prstshojaei/smart-indoor-air-quality-mould-monitor/evidence/Evidence_of_system.docx

Evidence of system

# Part A. Hardware design

## System


System architecture

## Schematic


Power input and charging


Battery and voltage regulation


5 V boost converter


Microcontroller


Programming header


CO2 sensor


Air quality sensor


PM2.5 sensor connector


OLED display


Status LED

## PCB layout and design check


PCB layout, 2D


PCB layout, 2D


PCB, 3D top side


PCB, 3D bottom side


Design Rule Check report

# Part B. Evidence

## Prototype and components


Breadboard prototype


ESP32 board


SCD40 CO2 sensor


BME688 sensor


PMS5003 PM2.5 sensor


PMS5003 panel


PMS5003 UART adapter

## OLED display and serial output


OLED readings page


OLED network page


OLED mould-score page


Serial console, start-up


Serial console, WiFi and web server

## Web dashboard and data log


Dashboard, main page


Dashboard, lower part


Dashboard on a phone, main page


Dashboard on a phone, trend page


Trend page, 24 hours


Trend page, 7 days


CSV log in Excel

## Algorithm validation


Synthetic dataset

Python reference run


ESP32 test run


Mould index over the year

## Real-world test


Dashboard, 19 September 23:58


Dashboard 7-day temperature


Dashboard 7-day humidity

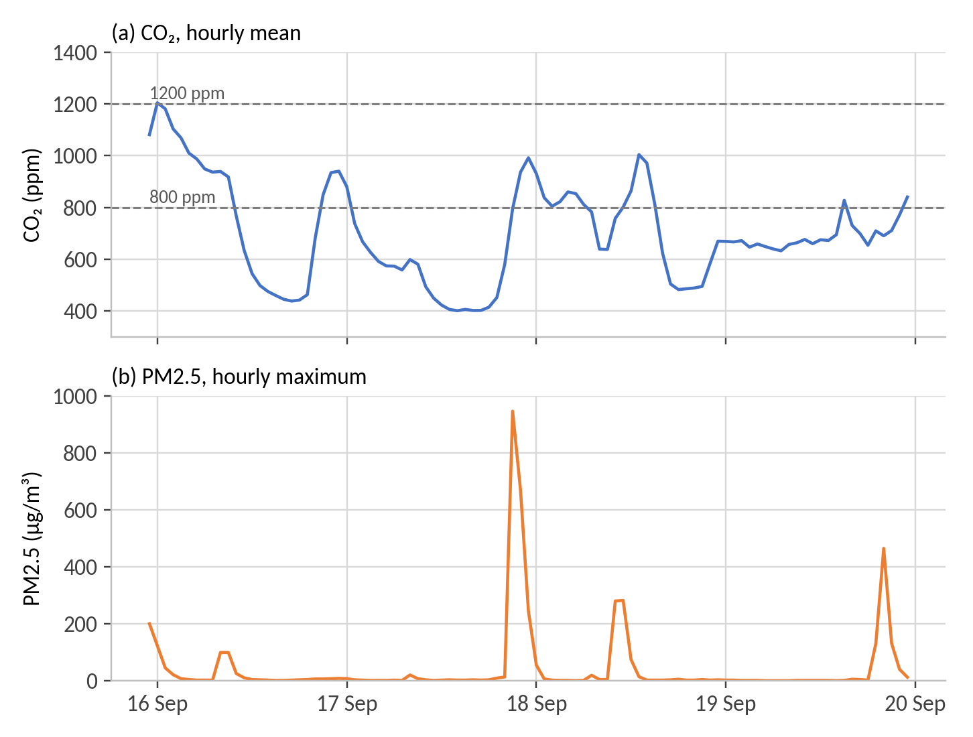
[picture p49: figure]

CO2 and PM2.5, real log

## Comparison with the Airthings Wave Mini


Prototype and Wave Mini


Wave Mini 7-day temperature


Wave Mini 7-day humidity


Wave Mini app, 19 September 23:57


Wave Mini colour light
