prstshojaei/smart-indoor-air-quality-mould-monitor/Evidence/Evidence of system.pdf

# Evidence of system

# Part A. Hardware design

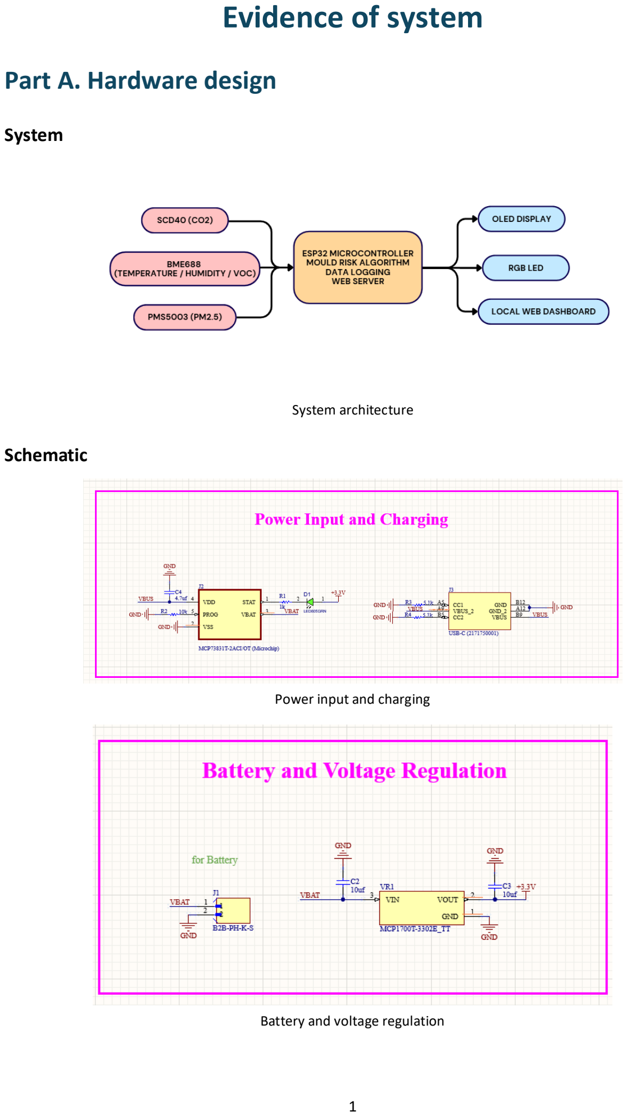
[picture p50: page 1]

## System

System architecture

## Schematic

Power input and charging

Battery and voltage regulation

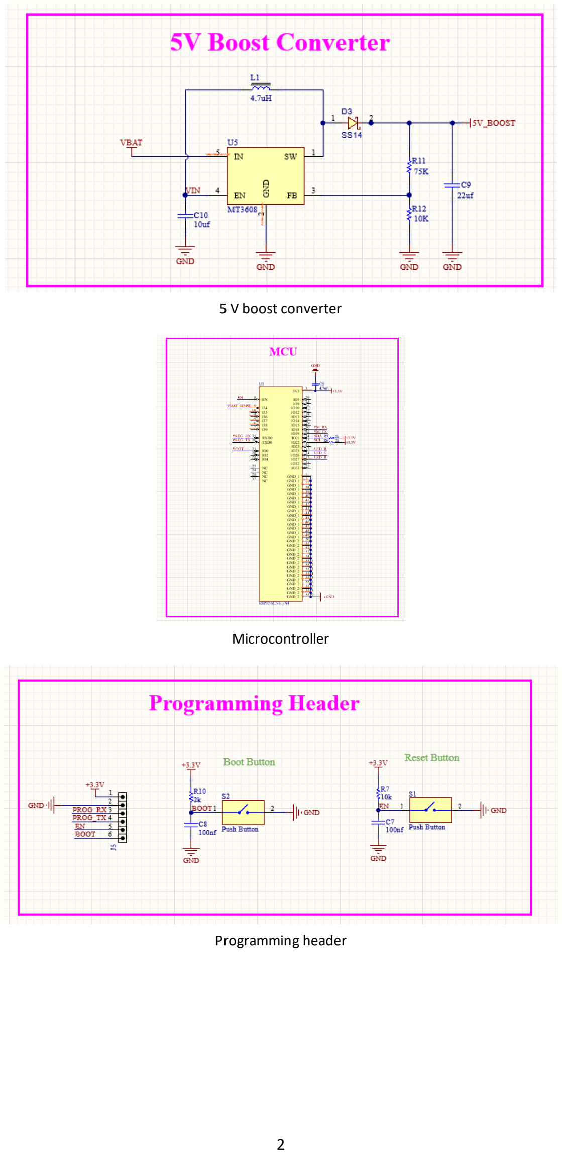
[picture p51: page 2]

5 V boost converter

Microcontroller

Programming header

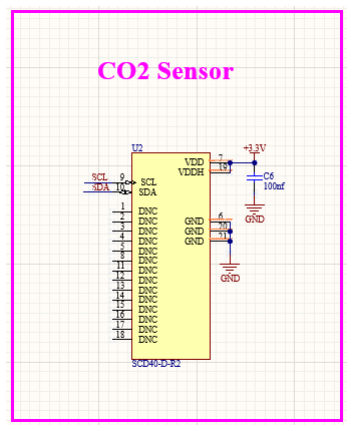
[picture p52: figure]

CO2 sensor

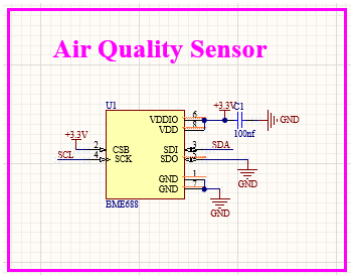
[picture p53: figure]

Air quality sensor

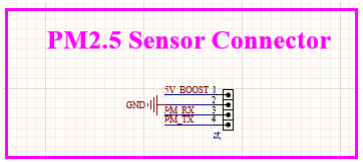
[picture p54: figure]

PM2.5 sensor connector

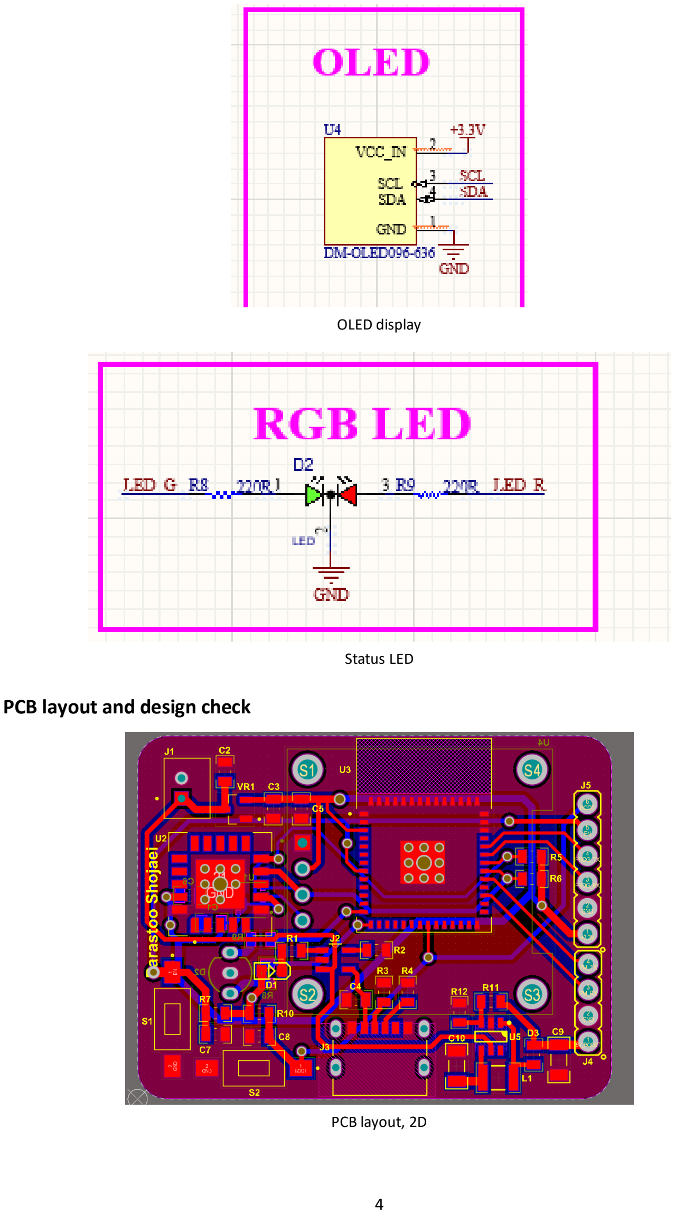
[picture p55: page 4]

OLED display

Status LED

## PCB layout and design check

PCB layout, 2D

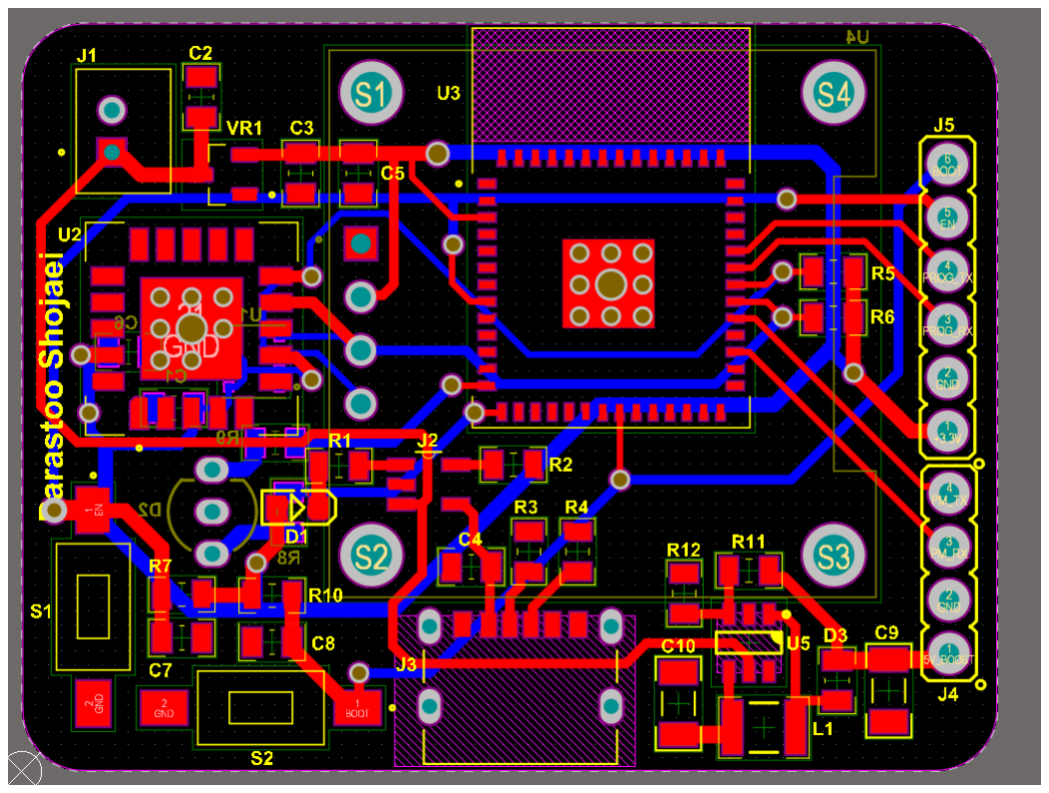
[picture p56: figure]

PCB layout, 2D

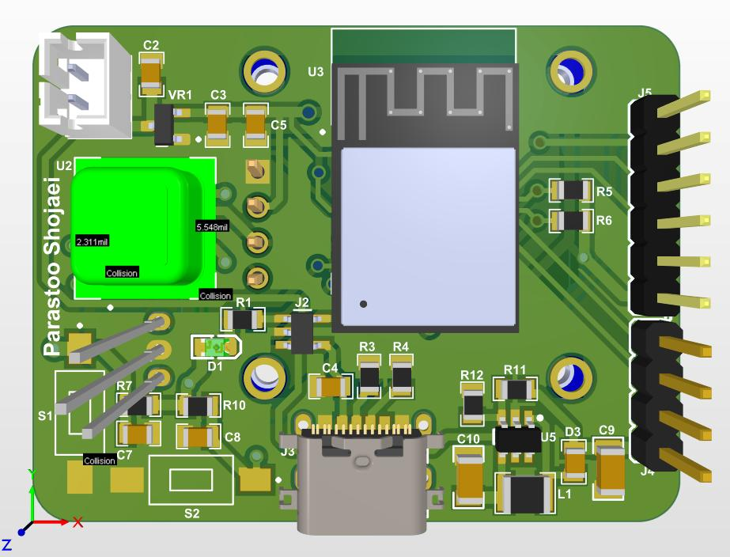
[picture p57: figure]

PCB, 3D top side

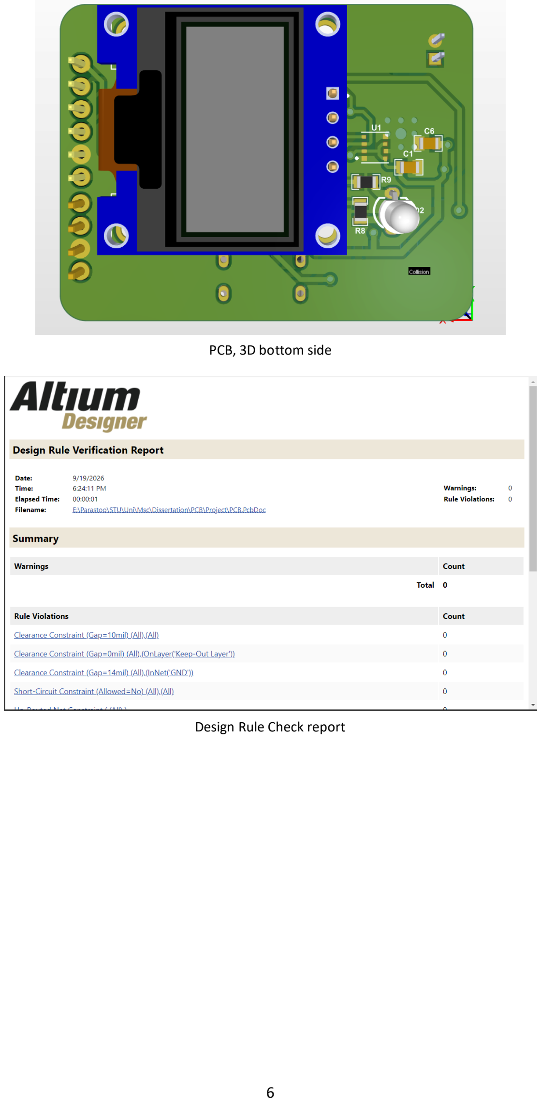
[picture p58: page 6]

PCB, 3D bottom side

Design Rule Check report

# Part B. Evidence

## Prototype and components

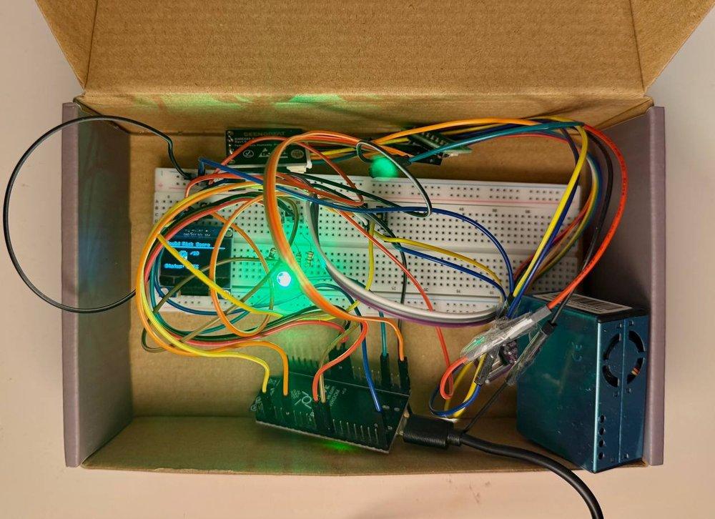
[picture p59: figure]

Breadboard prototype

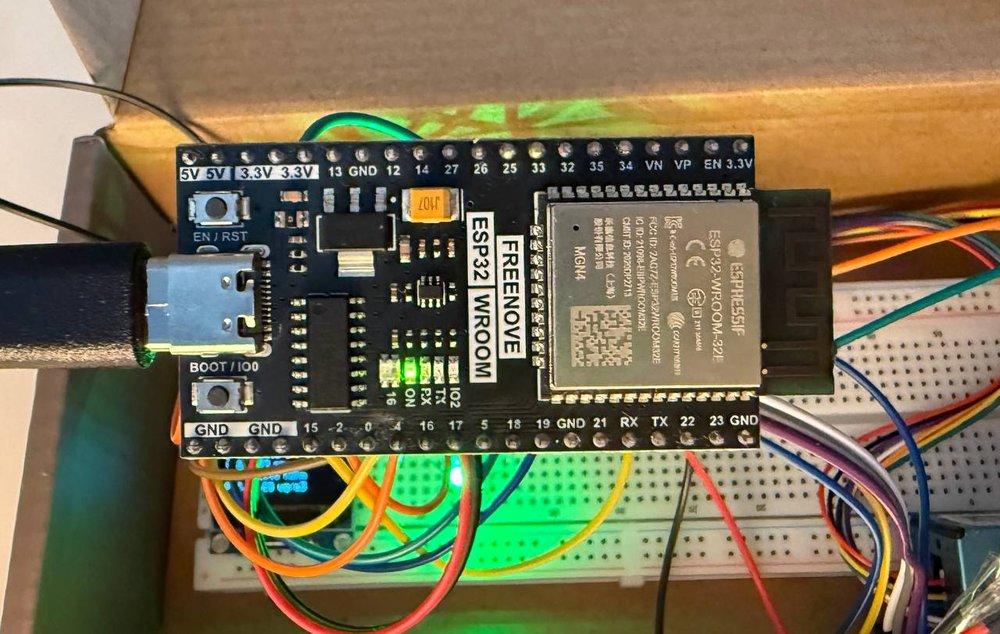
[picture p60: figure]

ESP32 board

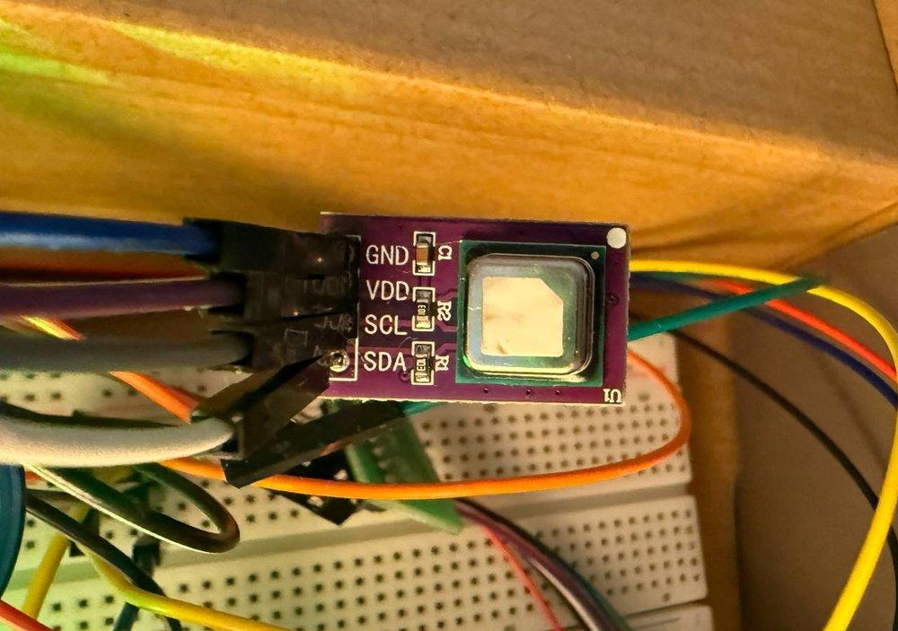
[picture p61: figure]

SCD40 CO2 sensor

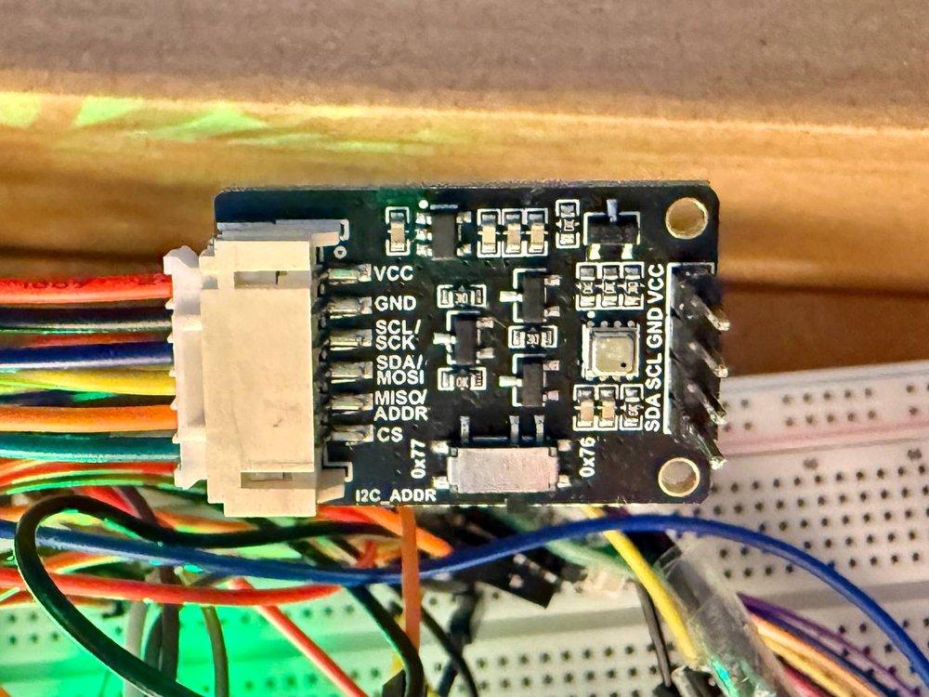
[picture p62: figure]

BME688 sensor

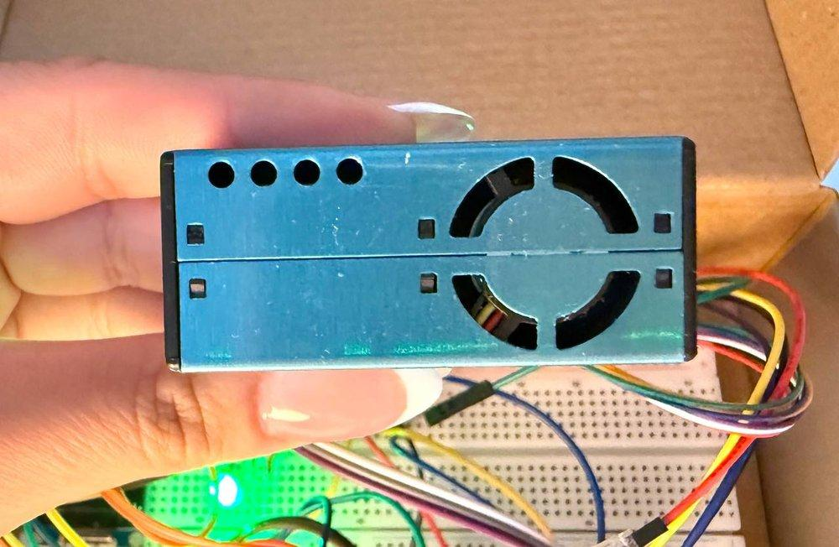
[picture p63: figure]

PMS5003 PM2.5 sensor

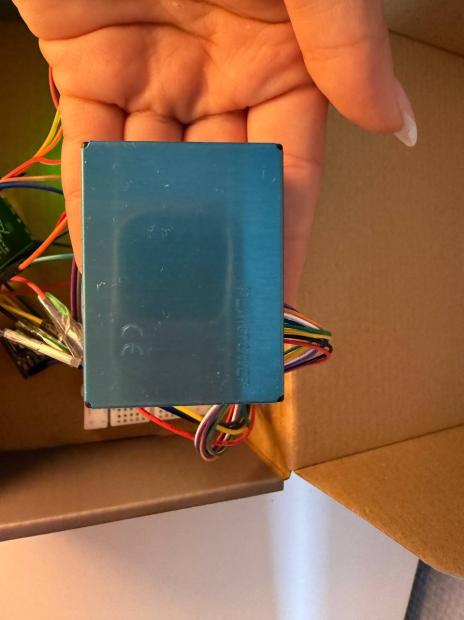
[picture p64: figure]

PMS5003 panel

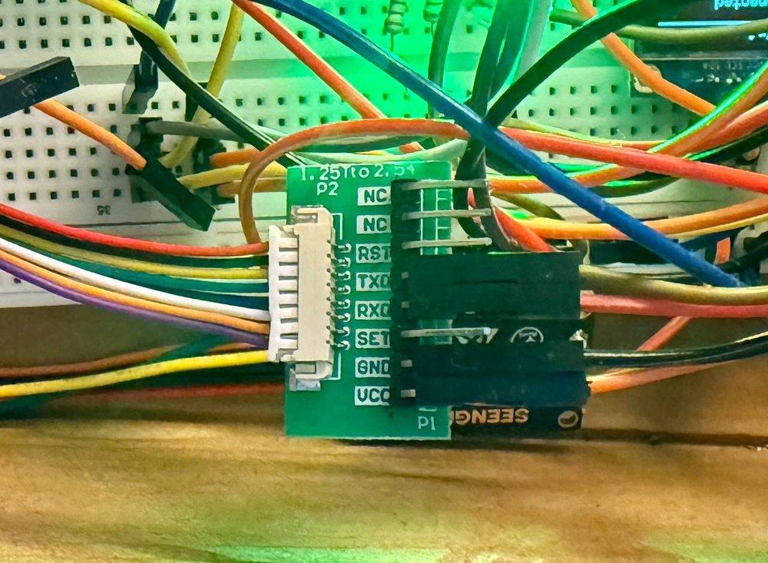
[picture p65: figure]

PMS5003 UART adapter

## OLED display and serial output

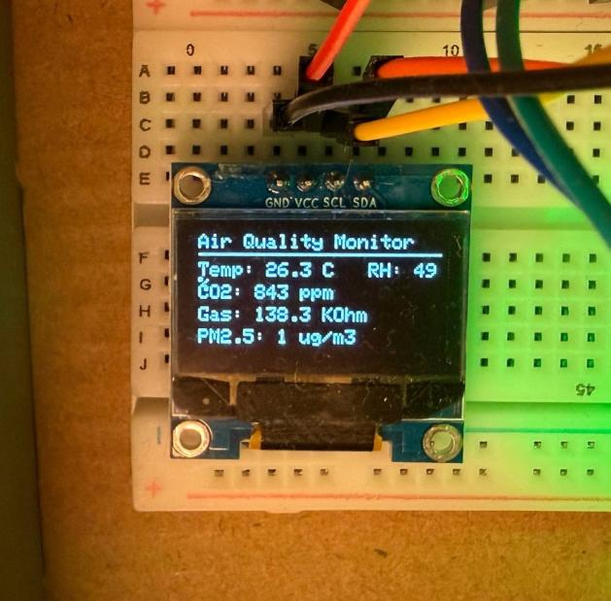
[picture p66: figure]

OLED readings page

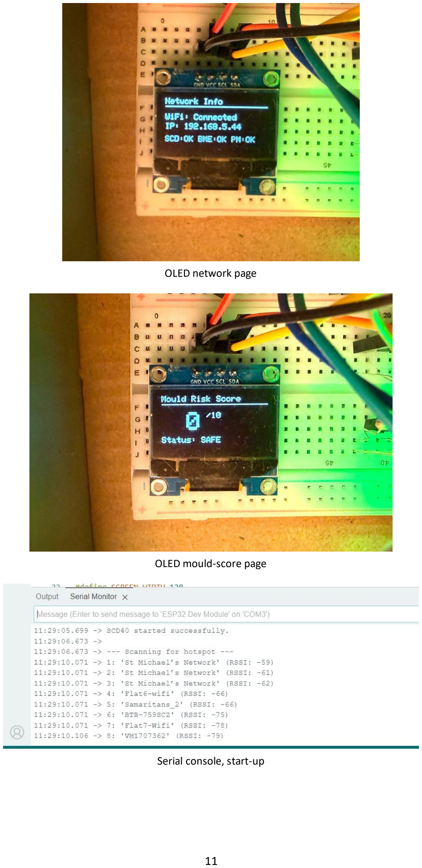
[picture p67: page 11]

OLED network page

OLED mould-score page

Serial console, start-up

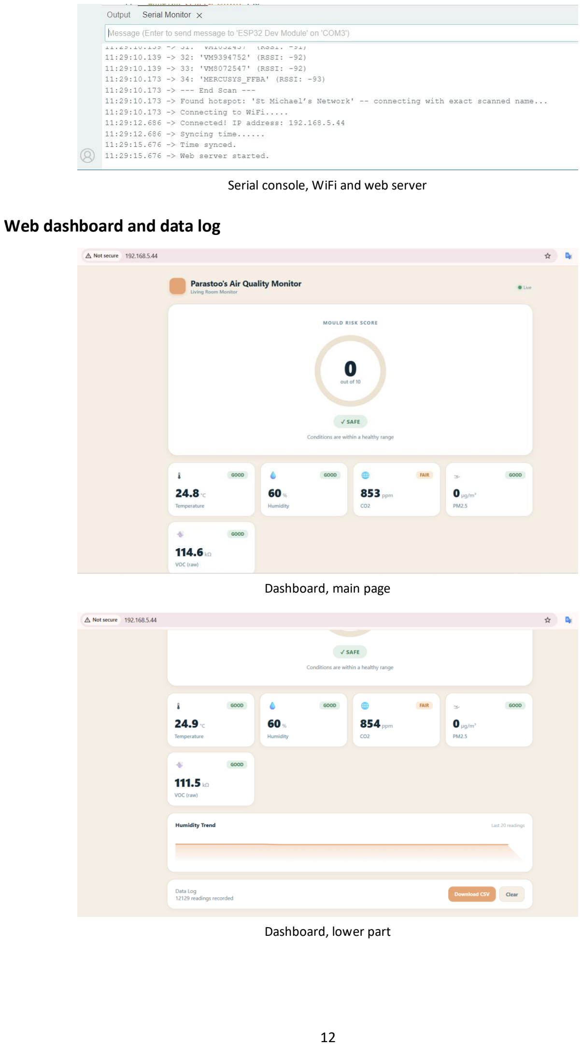
[picture p68: page 12]

Serial console, WiFi and web server

## Web dashboard and data log

Dashboard, main page

Dashboard, lower part

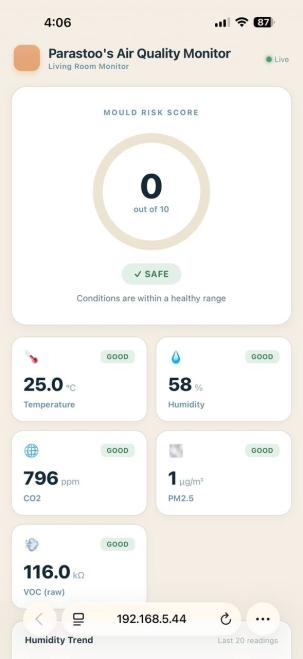
[picture p69: figure]

Dashboard on a phone, main page

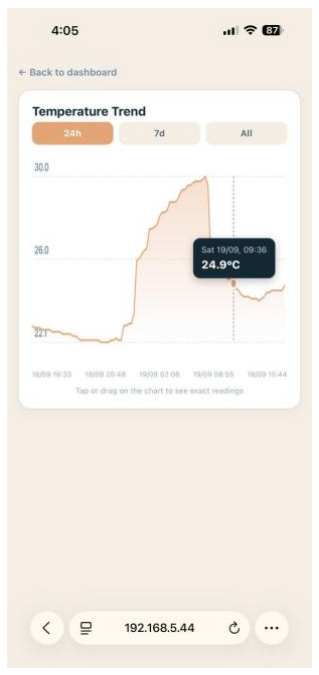
[picture p70: figure]

Dashboard on a phone, trend page

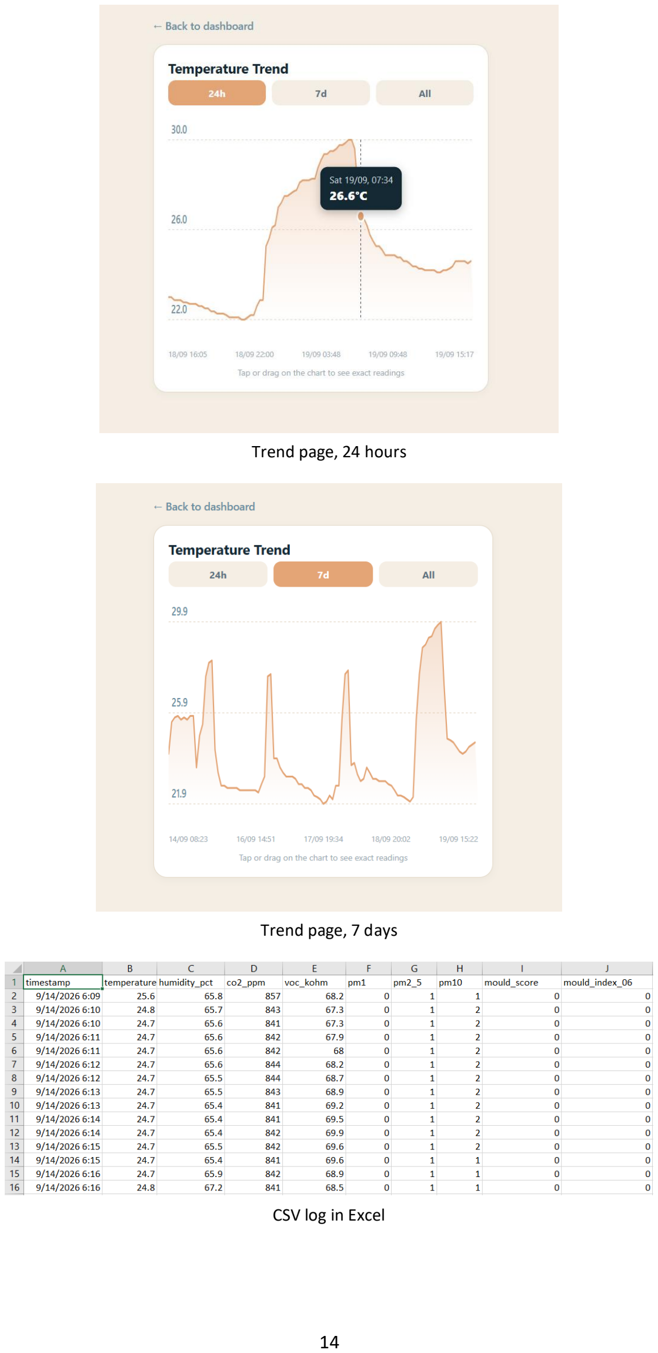
[picture p71: page 14]

Trend page, 24 hours

Trend page, 7 days

CSV log in Excel

## Algorithm validation

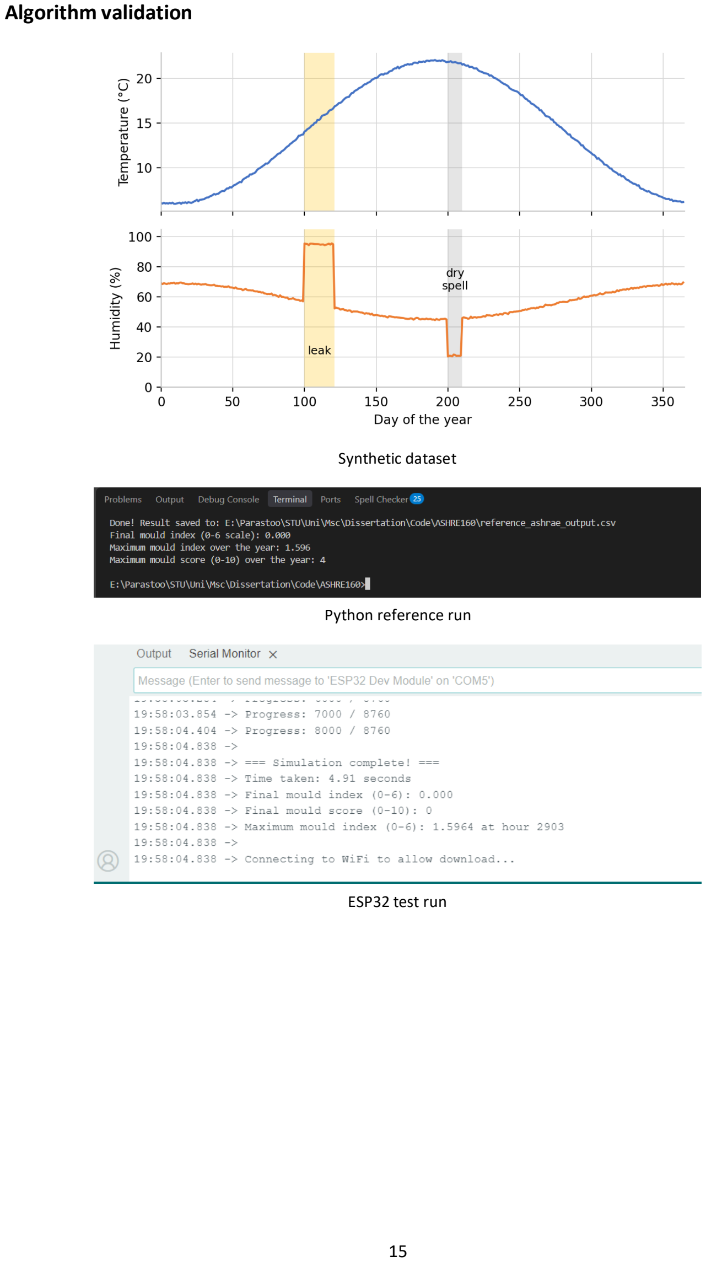
[picture p72: page 15]

Synthetic dataset

Python reference run

ESP32 test run


Mould index over the year

## Real-world test

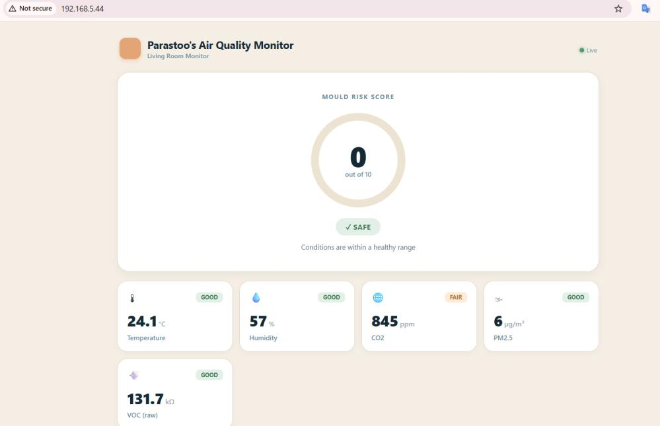
[picture p73: figure]

Dashboard, 19 September 23:58


Dashboard 7-day temperature


Dashboard 7-day humidity

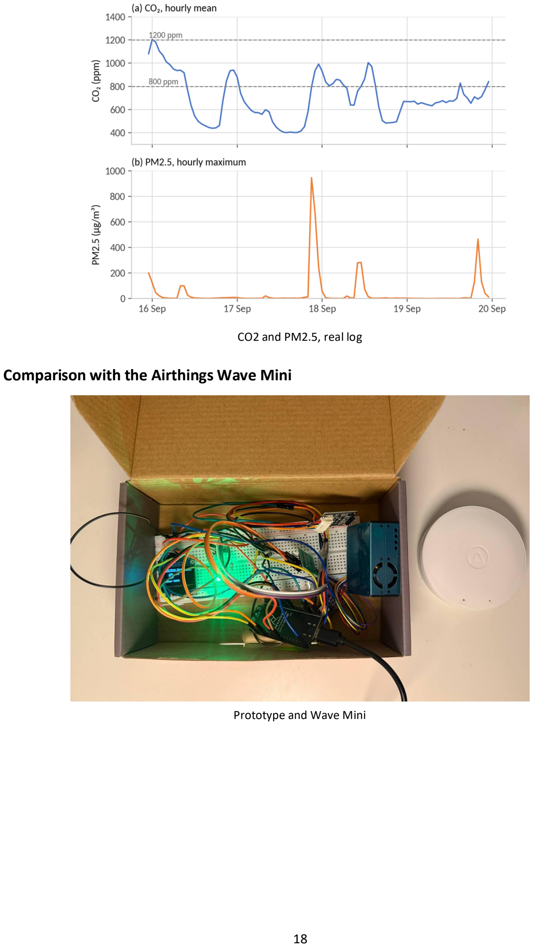
[picture p74: page 18]

CO2 and PM2.5, real log

## Comparison with the Airthings Wave Mini

Prototype and Wave Mini

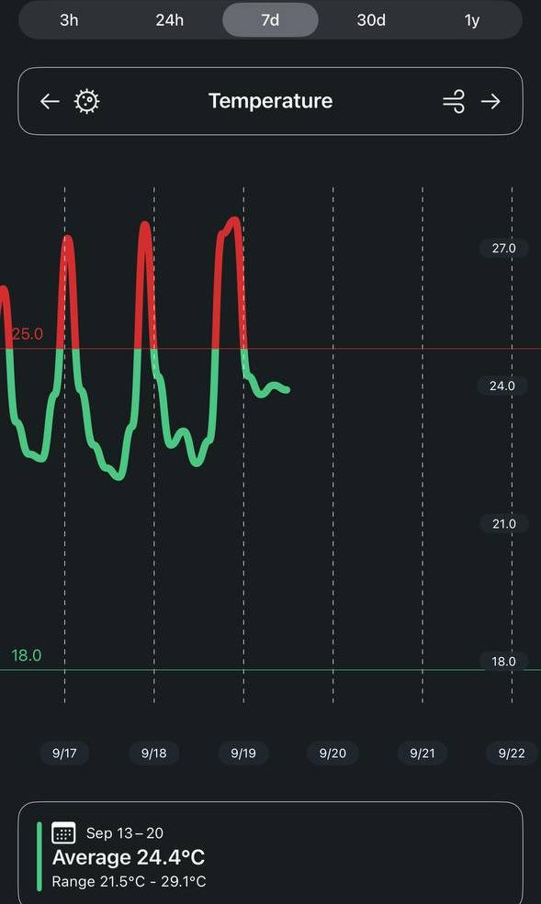
[picture p75: figure]

Wave Mini 7-day temperature

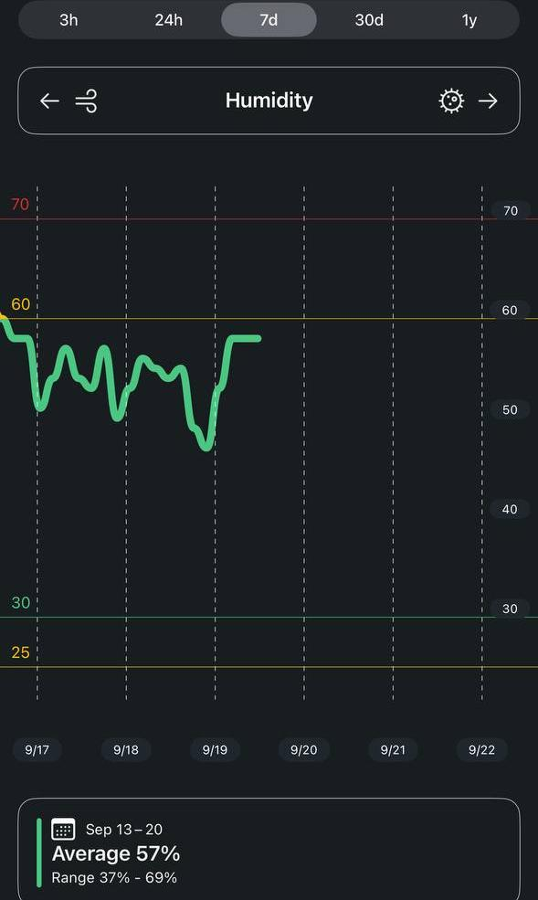
[picture p76: figure]

Wave Mini 7-day humidity

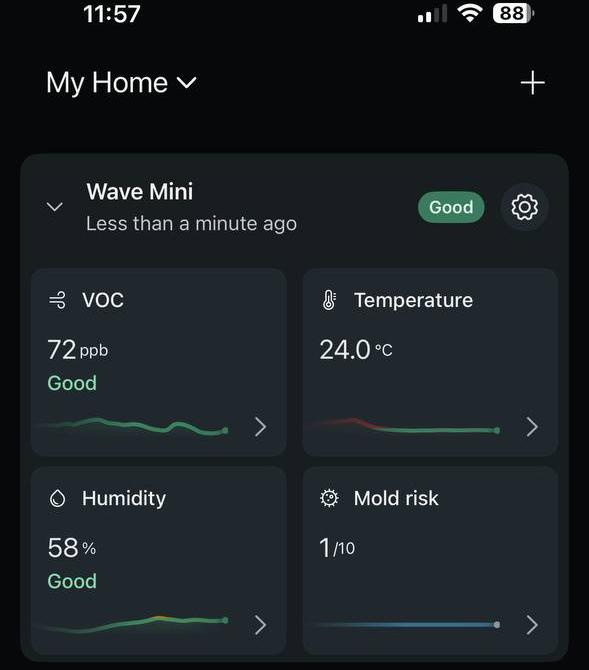
[picture p77: figure]

Wave Mini app, 19 September 23:57

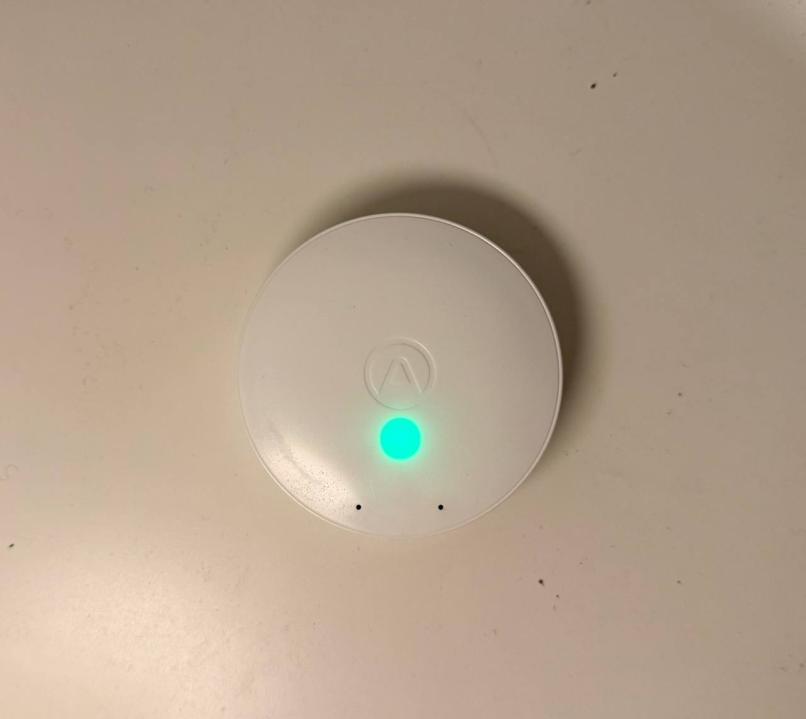
[picture p78: figure]

Wave Mini colour light
