prstshojaei/smart-indoor-air-quality-mould-monitor/tests/python/reference_ashrae_output.csv

hour | day | temperature_c | humidity_pct | ashrae_viitanen_index | mould_score_010
0 | 0 | 7.3 | 64.08 | 0.0 | 0
1 | 0 | 6.8 | 61.92 | 0.0 | 0
2 | 0 | 6.67 | 63.53 | 0.0 | 0
3 | 0 | 6.55 | 67.73 | 0.0 | 0
4 | 0 | 5.63 | 68.32 | 0.0 | 0
5 | 0 | 5.27 | 69.18 | 0.0 | 0
6 | 0 | 5.5 | 72.63 | 0.0 | 0
7 | 0 | 5.02 | 97.34 | 0.0016454877691745489 | 0
8 | 0 | 4.5 | 97.74 | 0.0032626619436276483 | 0
9 | 0 | 4.75 | 74.03 | 0.001929328610294315 | 0
10 | 0 | 4.5 | 72.1 | 0.0005959952769609817 | 0
11 | 0 | 4.65 | 74.41 | 0.0 | 0
12 | 0 | 5.1 | 69.92 | 0.0 | 0
13 | 0 | 4.77 | 70.85 | 0.0 | 0
14 | 0 | 5.18 | 70.57 | 0.0 | 0
15 | 0 | 5.92 | 64.8 | 0.0 | 0
16 | 0 | 6.17 | 64.8 | 0.0 | 0
17 | 0 | 6.93 | 65.58 | 0.0 | 0
18 | 0 | 6.88 | 64.36 | 0.0 | 0
19 | 0 | 6.97 | 61.41 | 0.0 | 0
20 | 0 | 7.98 | 59.97 | 0.0 | 0
21 | 0 | 7.52 | 62.3 | 0.0 | 0
22 | 0 | 7.56 | 62.84 | 0.0 | 0
23 | 0 | 6.96 | 59.92 | 0.0 | 0
24 | 1 | 6.97 | 60.84 | 0.0 | 0
25 | 1 | 6.85 | 64.23 | 0.0 | 0
26 | 1 | 6.11 | 66.28 | 0.0 | 0
27 | 1 | 6.18 | 66.44 | 0.0 | 0
28 | 1 | 5.5 | 69.47 | 0.0 | 0
29 | 1 | 5.23 | 68.83 | 0.0 | 0
30 | 1 | 4.83 | 67.96 | 0.0 | 0
31 | 1 | 5.33 | 96.45 | 0.0015084817281283006 | 0
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
