prstshojaei/smart-indoor-air-quality-mould-monitor/tests/python/synthetic_12month_dataset.csv

hour | day | temperature_c | humidity_pct
0 | 0 | 7.3 | 64.08
1 | 0 | 6.8 | 61.92
2 | 0 | 6.67 | 63.53
3 | 0 | 6.55 | 67.73
4 | 0 | 5.63 | 68.32
5 | 0 | 5.27 | 69.18
6 | 0 | 5.5 | 72.63
7 | 0 | 5.02 | 97.34
8 | 0 | 4.5 | 97.74
9 | 0 | 4.75 | 74.03
10 | 0 | 4.5 | 72.1
11 | 0 | 4.65 | 74.41
12 | 0 | 5.1 | 69.92
13 | 0 | 4.77 | 70.85
14 | 0 | 5.18 | 70.57
15 | 0 | 5.92 | 64.8
16 | 0 | 6.17 | 64.8
17 | 0 | 6.93 | 65.58
18 | 0 | 6.88 | 64.36
19 | 0 | 6.97 | 61.41
20 | 0 | 7.98 | 59.97
21 | 0 | 7.52 | 62.3
22 | 0 | 7.56 | 62.84
23 | 0 | 6.96 | 59.92
24 | 1 | 6.97 | 60.84
25 | 1 | 6.85 | 64.23
26 | 1 | 6.11 | 66.28
27 | 1 | 6.18 | 66.44
28 | 1 | 5.5 | 69.47
29 | 1 | 5.23 | 68.83
30 | 1 | 4.83 | 67.96
31 | 1 | 5.33 | 96.45
32 | 1 | 4.62 | 97.78
33 | 1 | 4.25 | 72.48
34 | 1 | 4.87 | 70.95
35 | 1 | 4.41 | 69.37
36 | 1 | 5.07 | 70.36
37 | 1 | 4.73 | 71.24
38 | 1 | 5.28 | 70.33
39 | 1 | 6.13 | 68.67
40 | 1 | 6.68 | 64.12
41 | 1 | 6.87 | 62.16
42 | 1 | 7.1 | 63.4
43 | 1 | 7.28 | 62.65
44 | 1 | 7.08 | 61.7
45 | 1 | 7.36 | 57.87
46 | 1 | 7.38 | 59.8
47 | 1 | 7.69 | 61.65
48 | 2 | 7.22 | 63.41
49 | 2 | 6.28 | 65.07
50 | 2 | 6.54 | 65.58
51 | 2 | 5.94 | 67.42
52 | 2 | 5.46 | 68.6
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
