prstshojaei/smart-indoor-air-quality-mould-monitor/Tests/esp32_test_sketch/test_mould_algorithm/test_results_12month.csv

hour | temperature_c | humidity_pct | rhcrit | mould_index_06 | mould_score_010
0 | 7.30 | 64.08 | 84.64 | 0.0000 | 0
1 | 6.80 | 61.92 | 85.27 | 0.0000 | 0
2 | 6.67 | 63.53 | 85.45 | 0.0000 | 0
3 | 6.55 | 67.73 | 85.61 | 0.0000 | 0
4 | 5.63 | 68.32 | 86.97 | 0.0000 | 0
5 | 5.27 | 69.18 | 87.56 | 0.0000 | 0
6 | 5.50 | 72.63 | 87.18 | 0.0000 | 0
7 | 5.02 | 97.34 | 87.98 | 0.0016 | 0
8 | 4.50 | 97.74 | 88.91 | 0.0033 | 0
9 | 4.75 | 74.03 | 88.46 | 0.0019 | 0
10 | 4.50 | 72.10 | 88.91 | 0.0006 | 0
11 | 4.65 | 74.41 | 88.64 | 0.0000 | 0
12 | 5.10 | 69.92 | 87.84 | 0.0000 | 0
13 | 4.77 | 70.85 | 88.42 | 0.0000 | 0
14 | 5.18 | 70.57 | 87.71 | 0.0000 | 0
15 | 5.92 | 64.80 | 86.52 | 0.0000 | 0
16 | 6.17 | 64.80 | 86.15 | 0.0000 | 0
17 | 6.93 | 65.58 | 85.10 | 0.0000 | 0
18 | 6.88 | 64.36 | 85.17 | 0.0000 | 0
19 | 6.97 | 61.41 | 85.05 | 0.0000 | 0
20 | 7.98 | 59.97 | 83.85 | 0.0000 | 0
21 | 7.52 | 62.30 | 84.38 | 0.0000 | 0
22 | 7.56 | 62.84 | 84.33 | 0.0000 | 0
23 | 6.96 | 59.92 | 85.07 | 0.0000 | 0
24 | 6.97 | 60.84 | 85.05 | 0.0000 | 0
25 | 6.85 | 64.23 | 85.21 | 0.0000 | 0
26 | 6.11 | 66.28 | 86.24 | 0.0000 | 0
27 | 6.18 | 66.44 | 86.14 | 0.0000 | 0
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
