prstshojaei/smart-indoor-air-quality-mould-monitor/(list of files, drawings)

Other design files:
Hardware/Altium_project/Project/PCB.PcbDoc
Hardware/Altium_project/Project/Project.PrjPcb
Hardware/Altium_project/Project/Schematic.SchDoc
